stanhchiu/FlowBaton/exports/retaining_ring.stl

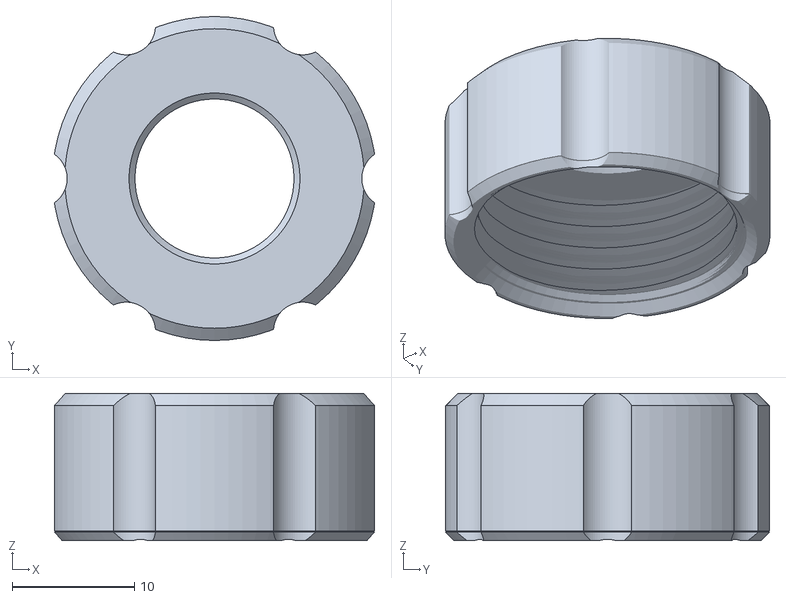
[picture p1: CAD file, 2026-08-22]
exports/retaining_ring.stl
26.2 x 26.5 x 12.1
