stanhchiu/FlowBaton/(list of files, cad)

Other CAD files:
print/end_cap.3mf
print/drill_jig.3mf
exports/drill_jig.stl
exports/end_cap.stl
