stanhchiu/FlowBaton/(commit log)

2026-08-21 Fix retaining ring thread handedness, radial clearance, and update separate 3MF files
    [baton.3mf, end_cap.3mf, end_cap.scad, end_cap.stl, retaining_ring.3mf, retaining_ring.scad, retaining_ring.stl]
2026-08-21 Restore original baton.3mf
    [baton.3mf, end_cap.3mf, retaining_ring.3mf]
2026-08-21 Restore original uncorrupted baton.3mf with proper plate dimensions
    [baton.3mf]
2026-08-21 Update seam position to back and layer height to 0.16mm in 3MF project files
    [baton.3mf, end_cap.3mf, retaining_ring.3mf]
2026-08-21 Update seam position setting to 'aligned back' for Creality Print compatibility
    [end_cap.3mf, retaining_ring.3mf]
2026-08-22 Upgrade curve resolution to 72 points and update retaining ring inner opening to 12.8mm
    [end_cap.3mf, end_cap.scad, end_cap.stl, retaining_ring.3mf, retaining_ring.scad, retaining_ring.stl]
2026-08-22 Standardize seam_position to 'aligned_back' across all 3MF project files and guidelines
    [end_cap.3mf, retaining_ring.3mf]
2026-08-22 Update thread geometry to self-supporting 45-degree trapezoidal profile and 0.40mm radial clearance
    [end_cap.3mf, end_cap.scad, end_cap.stl, retaining_ring.3mf, retaining_ring.scad, retaining_ring.stl]
2026-08-22 Update retaining ring STL and 3MF mesh while preserving manual print settings
    [retaining_ring.3mf, retaining_ring.scad, retaining_ring.stl]
2026-08-24 Disable Z-hop (retract lift = 0) in 3MF projects to eliminate PETG stringing
    [end_cap.3mf, retaining_ring.3mf]
2026-08-24 Rework end cap to standard GPI 22-410 bottle neck finish
    [end_cap.3mf, end_cap.scad, end_cap.stl]
2026-08-24 Extend threads to collar shoulder and make 8.3mm center hole continuous into glowstick pocket
    [end_cap.3mf, end_cap.scad, end_cap.stl]
2026-08-26 Shorten neck threads to 10.5mm and raise collar shoulder by 3mm for 22-410 cap fit
    [end_cap.3mf, end_cap.scad, end_cap.stl, retaining_ring.3mf]
2026-08-26 Increase end cap collar shoulder diameter to 25.80mm (+1.0mm)
    [end_cap.3mf, end_cap.scad, end_cap.stl]
2026-08-26 Add 3D printable drill centering jig for 25.6mm bottle caps
    [drill_jig.3mf, drill_jig.scad, drill_jig.stl, end_cap.3mf]
2026-08-26 Raise shoulder height +1mm (shoulder_thickness=8.0, neck_height=9.5)
    [end_cap.3mf, end_cap.scad, end_cap.stl]
2026-08-26 Update end cap socket depth to 15.0mm (total height 32.5mm)
    [end_cap.3mf, end_cap.scad, end_cap.stl]
2026-08-26 Update end cap shaft socket depth to 10.0mm (total height 27.5mm)
    [end_cap.3mf, end_cap.scad, end_cap.stl]
2026-08-26 Update end cap with neck_height=9.0mm and pocket_depth=13.0mm to preload glowstick
    [end_cap.3mf, end_cap.scad, end_cap.stl]
2026-08-26 Fix 3MF mesh synchronization for Creality Print object reference
    [end_cap.3mf]
2026-08-26 Add automated scripts/sync_3mf.py tool and update AGENTS.md and README.md
    [drill_jig.3mf, end_cap.3mf, retaining_ring.3mf]
2026-09-16 Update drill jig to screw on and have a longer narrower sleeve
    [drill_jig.3mf, drill_jig.scad, drill_jig.stl, end_cap.3mf, retaining_ring.3mf, retaining_ring.scad]
2026-10-29 docs: add 8mm carbon fiber shaft sizing and sourcing details
